billieblaze/FDL-1-Blaster/FDL-1p Wiring Diagram.jpg

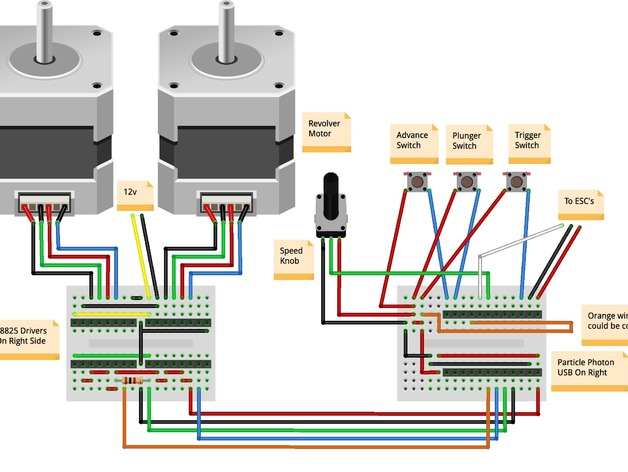
FDL-1p Wiring Diagram.jpg
