billieblaze/FDL-1-Blaster/PCB/FDL-1 Blaster Control PCB Schematic.png

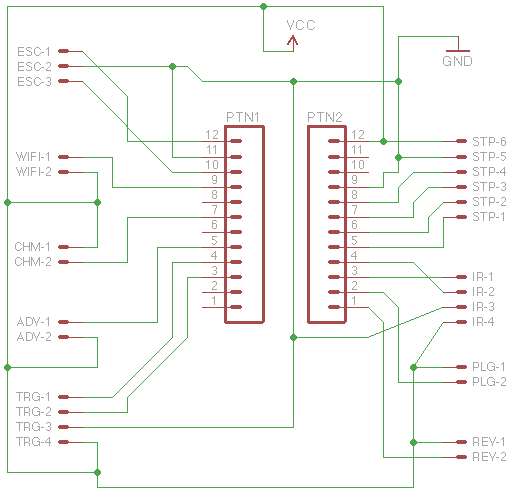
PCB/FDL-1 Blaster Control PCB Schematic.png
