billieblaze/FDL-1-Blaster/PCB/FDL-1 Blaster Stepper PCB Schematic.png

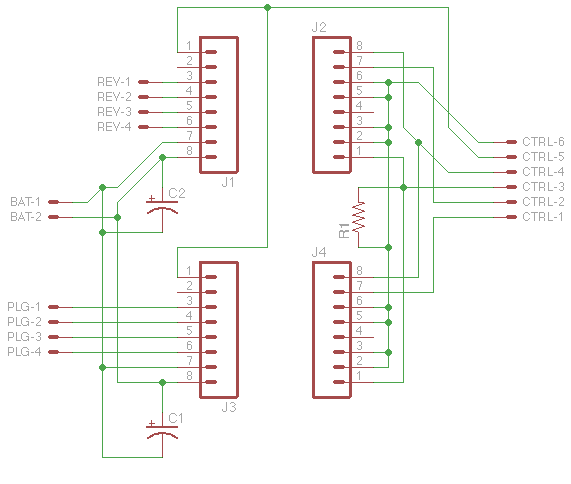
PCB/FDL-1 Blaster Stepper PCB Schematic.png
