billieblaze/FDL-1-Blaster/STL/FDL-1_Blaster_Revolver_Body_Main.stl

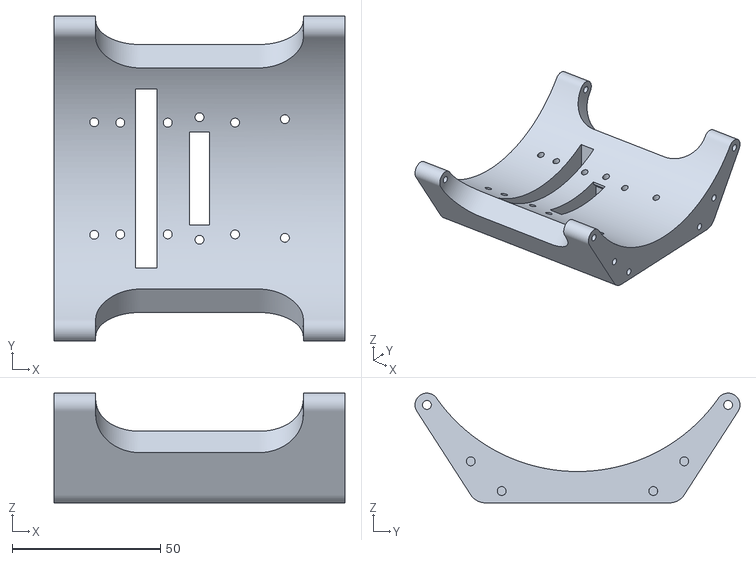
[picture p4: CAD file, 2016-08-03]
STL/FDL-1_Blaster_Revolver_Body_Main.stl
98.0 x 109.6 x 37.0
