billieblaze/FDL-1-Blaster/STL/FDL-1_Blaster_PCB_Mount_CTRL.stl

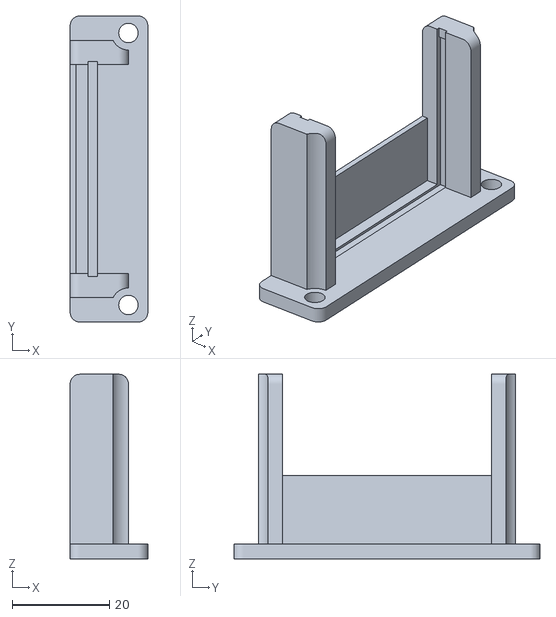
[picture p6: CAD file, 2016-08-03]
STL/FDL-1_Blaster_PCB_Mount_CTRL.stl
16.0 x 63.0 x 38.0
