billieblaze/FDL-1-Blaster/STL/FDL-1_Blaster_Barrel.stl

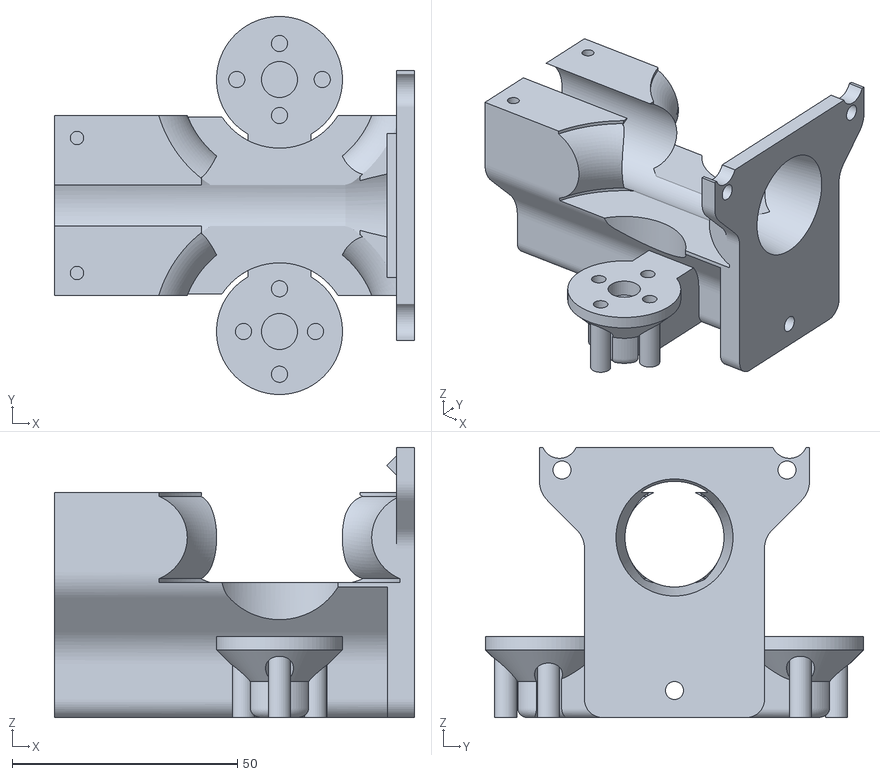
[picture p7: CAD file, 2016-08-03]
STL/FDL-1_Blaster_Barrel.stl
80.0 x 84.0 x 60.0
