billieblaze/FDL-1-Blaster/STL/FDL-1_Blaster_Rear_Spinner_Bushing.stl

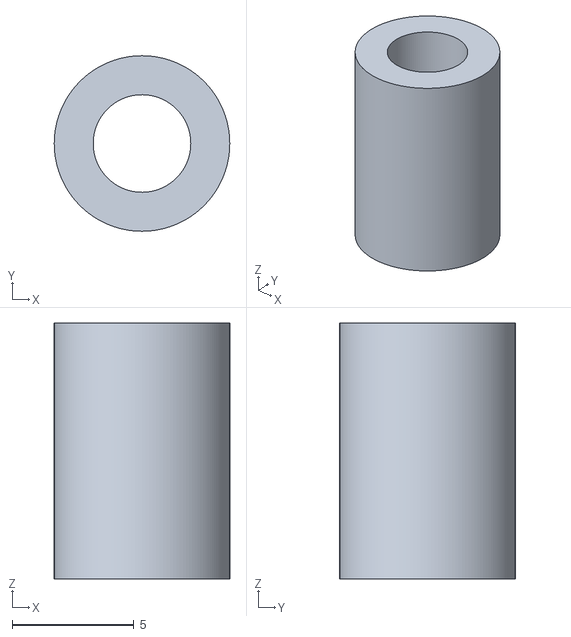
[picture p8: CAD file, 2016-08-03]
STL/FDL-1_Blaster_Rear_Spinner_Bushing.stl
7.20 x 7.20 x 10.5
