billieblaze/FDL-1-Blaster/STL/FDL-1_Blaster_Barrel_Guard_Cap.stl

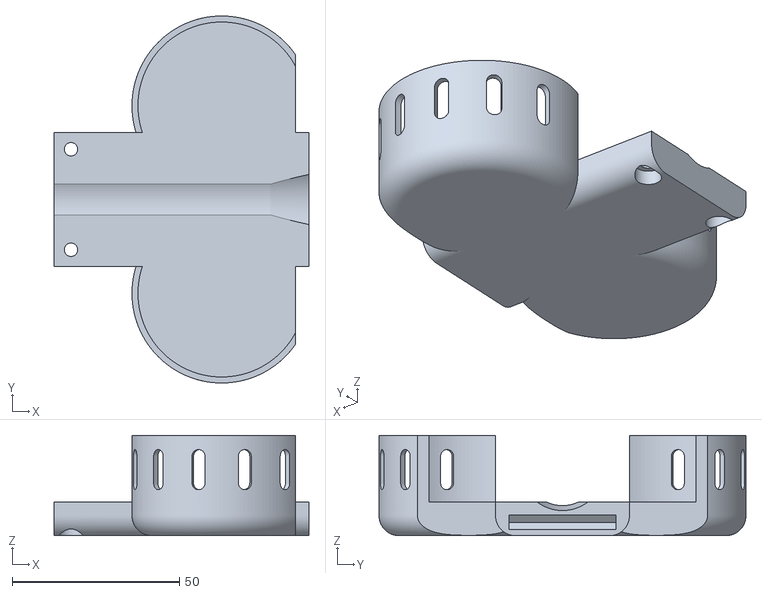
[picture p9: CAD file, 2016-08-03]
STL/FDL-1_Blaster_Barrel_Guard_Cap.stl
76.0 x 109.6 x 30.0
