billieblaze/FDL-1-Blaster/STL/FDL-1_Blaster_Rear_Angle_Right.stl

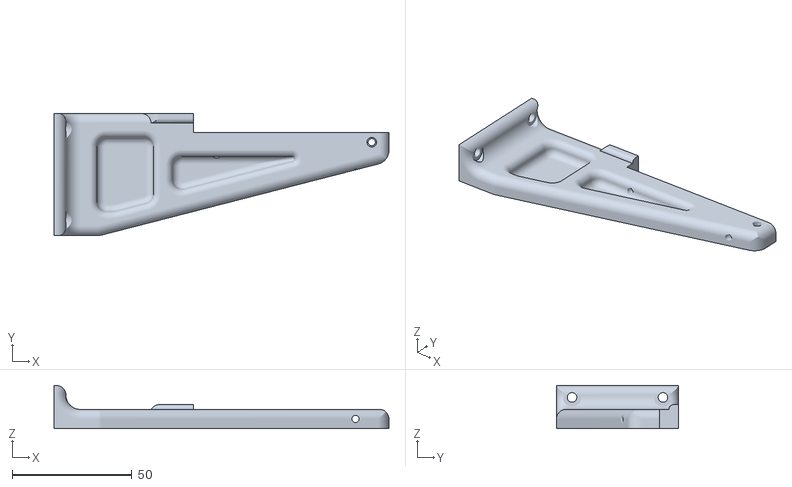
[picture p10: CAD file, 2016-08-03]
STL/FDL-1_Blaster_Rear_Angle_Right.stl
140.0 x 51.0 x 18.0
