billieblaze/FDL-1-Blaster/STL/FDL-1_Blaster_Revolver.stl

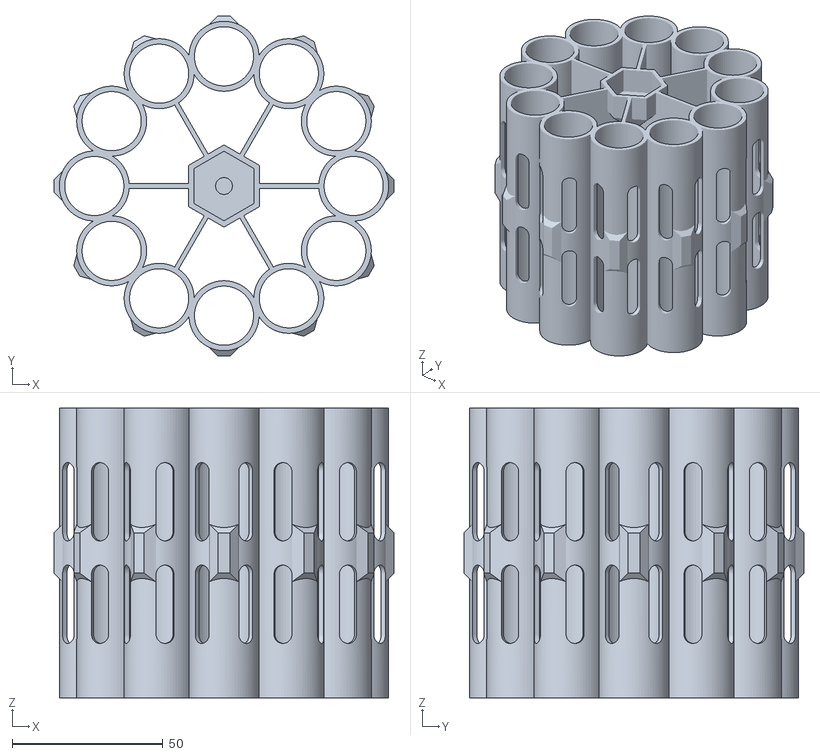
[picture p11: CAD file, 2016-08-03]
STL/FDL-1_Blaster_Revolver.stl
112.7 x 112.7 x 96.0
