billieblaze/FDL-1-Blaster/STL/FDL-1_Handle_Blaster_Plate.stl

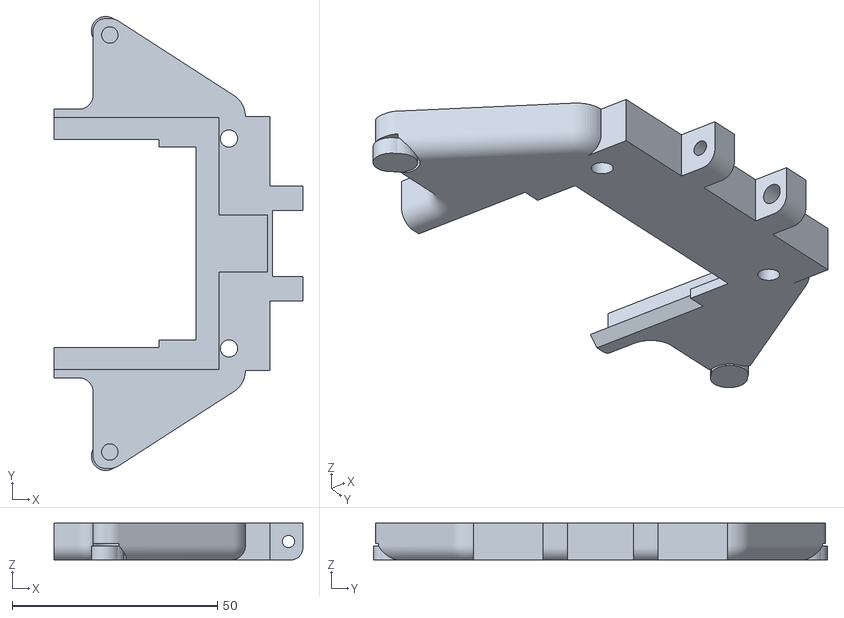
[picture p13: CAD file, 2016-08-03]
STL/FDL-1_Handle_Blaster_Plate.stl
60.6 x 110.6 x 9.00
