billieblaze/FDL-1-Blaster/STL/FDL-1_Blaster_PCB_Mount_STP.stl

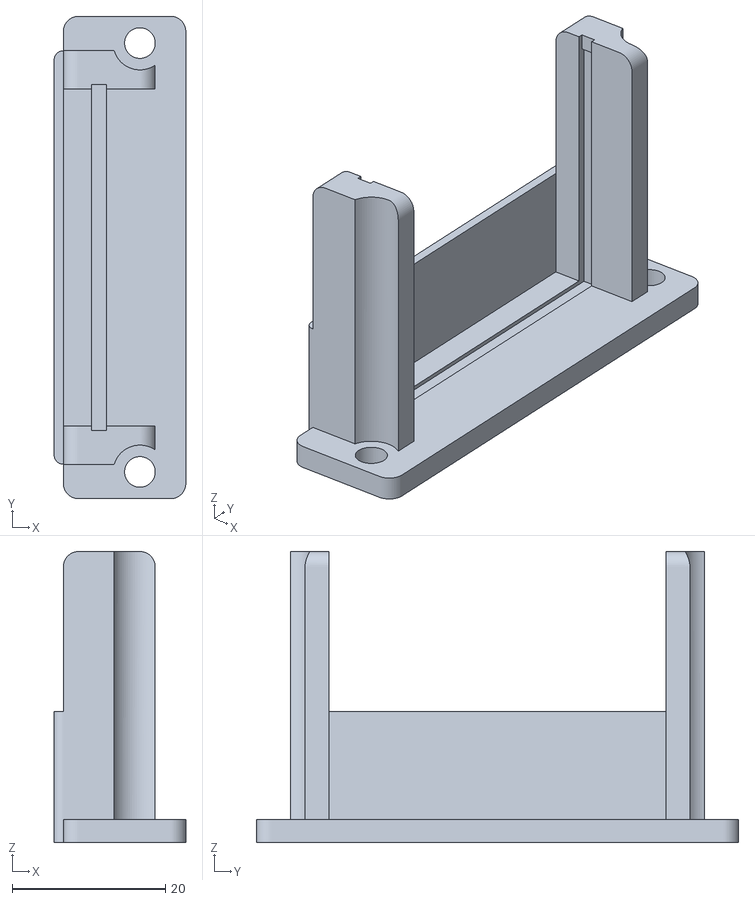
[picture p14: CAD file, 2016-08-03]
STL/FDL-1_Blaster_PCB_Mount_STP.stl
17.2 x 63.0 x 38.0
