billieblaze/FDL-1-Blaster/STL/FDL-1_Blaster_ESC_Power_Distro.stl

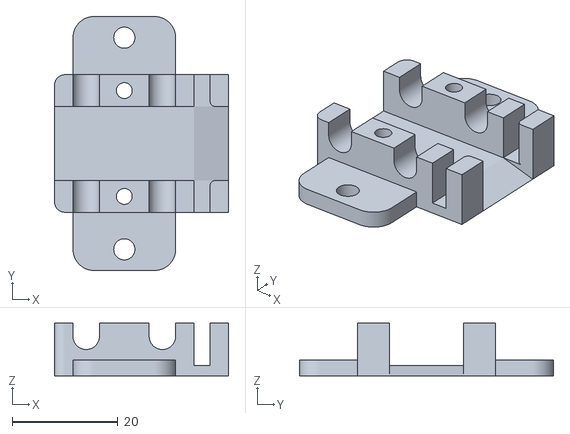
[picture p15: CAD file, 2016-08-03]
STL/FDL-1_Blaster_ESC_Power_Distro.stl
32.9 x 48.0 x 10.0
