billieblaze/FDL-1-Blaster/STL/FDL-1_Blaster_Flywheel_x2.stl

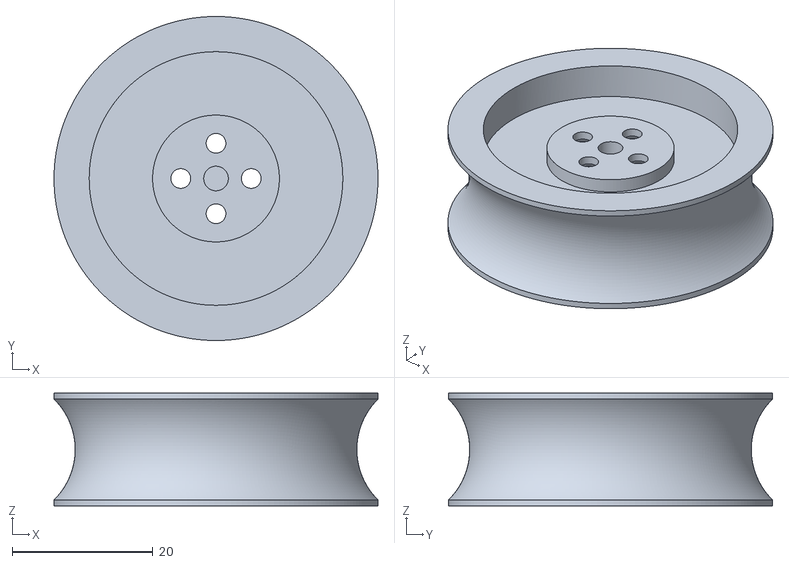
[picture p16: CAD file, 2016-08-03]
STL/FDL-1_Blaster_Flywheel_x2.stl
46.0 x 46.0 x 16.0
