billieblaze/FDL-1-Blaster/STL/FDL-1_Blaster_Revolver_Body_Brace_x2.stl

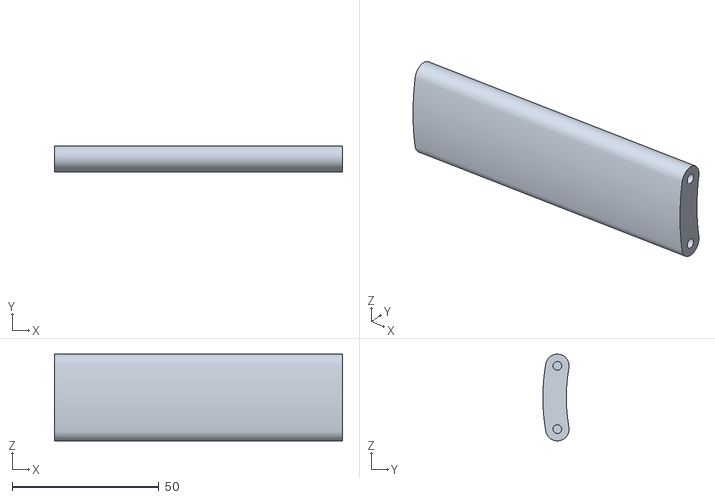
[picture p17: CAD file, 2016-08-03]
STL/FDL-1_Blaster_Revolver_Body_Brace_x2.stl
98.0 x 8.94 x 29.5
