billieblaze/FDL-1-Blaster/STL/FDL-1_Handle_Plate_Right.stl

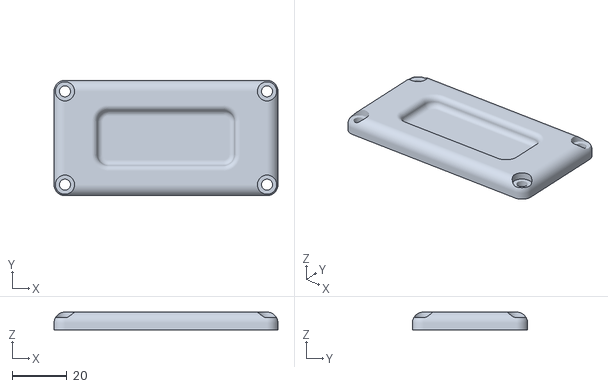
[picture p18: CAD file, 2016-08-03]
STL/FDL-1_Handle_Plate_Right.stl
81.6 x 42.0 x 6.50
