billieblaze/FDL-1-Blaster/STL/FDL-1_Blaster_ESC_Bracket_Left.stl

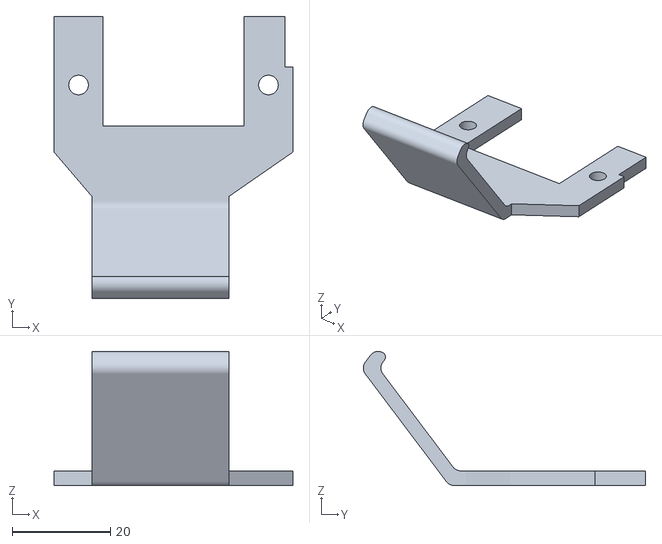
[picture p19: CAD file, 2016-08-03]
STL/FDL-1_Blaster_ESC_Bracket_Left.stl
48.7 x 57.6 x 27.3
