billieblaze/FDL-1-Blaster/STL/FDL-1_Blaster_Rear_Plate_Switch_Cap.stl

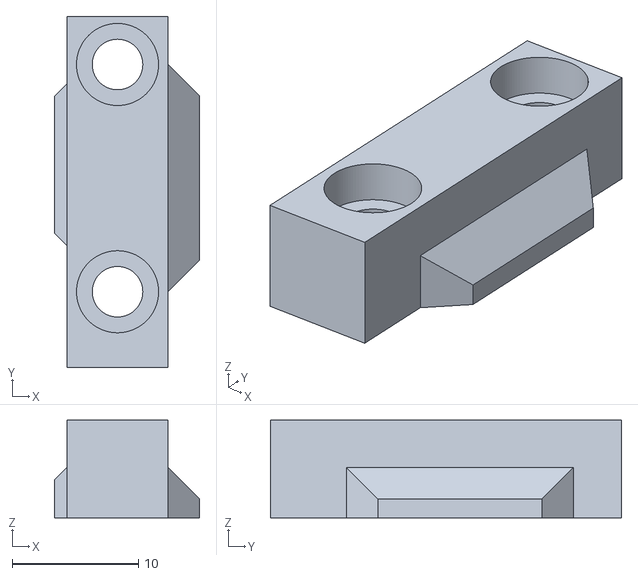
[picture p20: CAD file, 2016-08-03]
STL/FDL-1_Blaster_Rear_Plate_Switch_Cap.stl
11.5 x 27.8 x 7.75
