billieblaze/FDL-1-Blaster/STL/FDL-1_Blaster_Rear_Plunger_Guide_wSwitches.stl

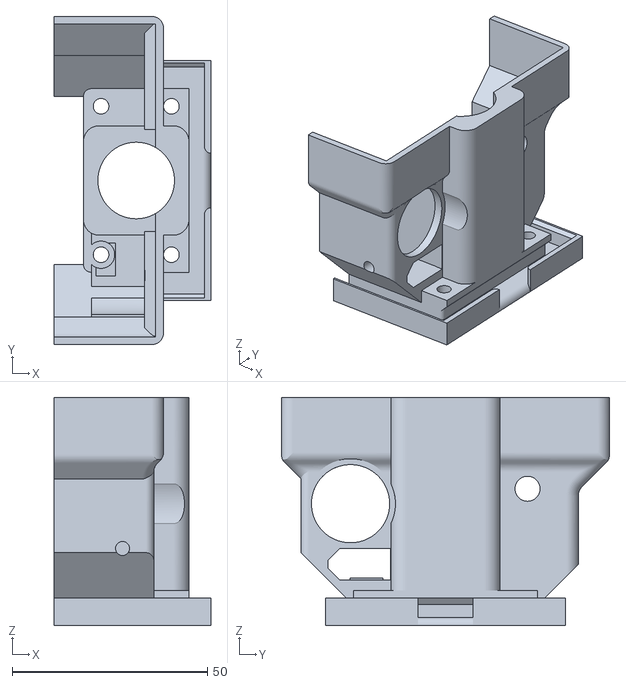
[picture p21: CAD file, 2016-08-03]
STL/FDL-1_Blaster_Rear_Plunger_Guide_wSwitches.stl
40.1 x 84.0 x 58.4
