billieblaze/FDL-1-Blaster/STL/FDL-1_Blaster_Rear_Angle_Left_Cap.stl

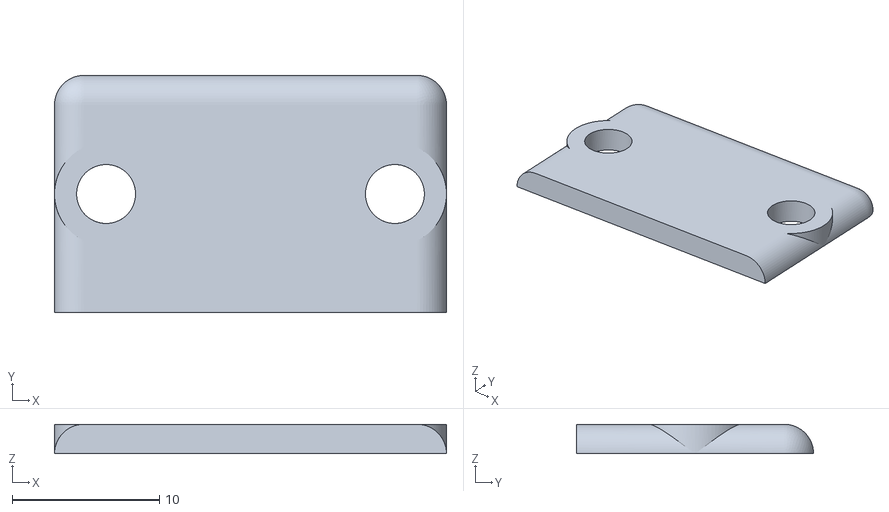
[picture p22: CAD file, 2016-08-03]
STL/FDL-1_Blaster_Rear_Angle_Left_Cap.stl
26.6 x 16.1 x 2.00
