billieblaze/FDL-1-Blaster/STL/FDL-1_Blaster_Rear_Plate.stl

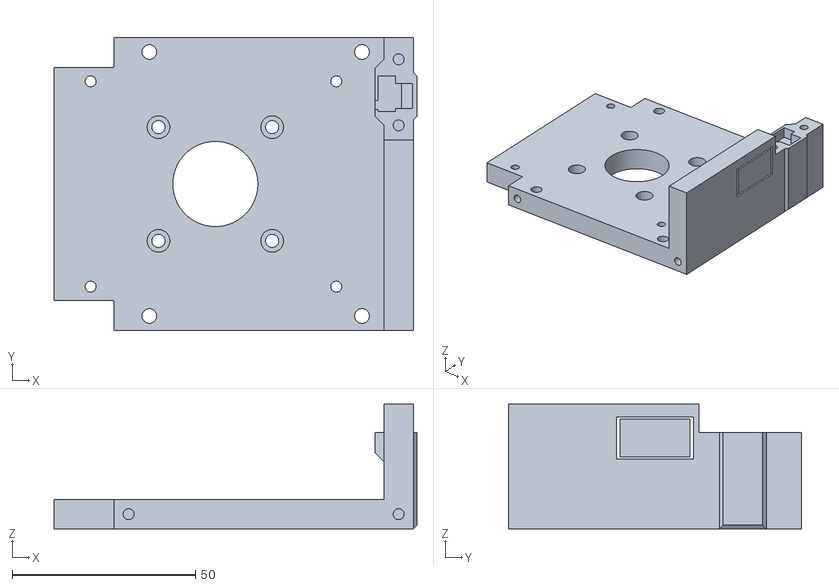
[picture p23: CAD file, 2016-08-03]
STL/FDL-1_Blaster_Rear_Plate.stl
99.0 x 80.0 x 34.0
