billieblaze/FDL-1-Blaster/STL/FDL-1_Blaster_Rear_Electronics_Box.stl

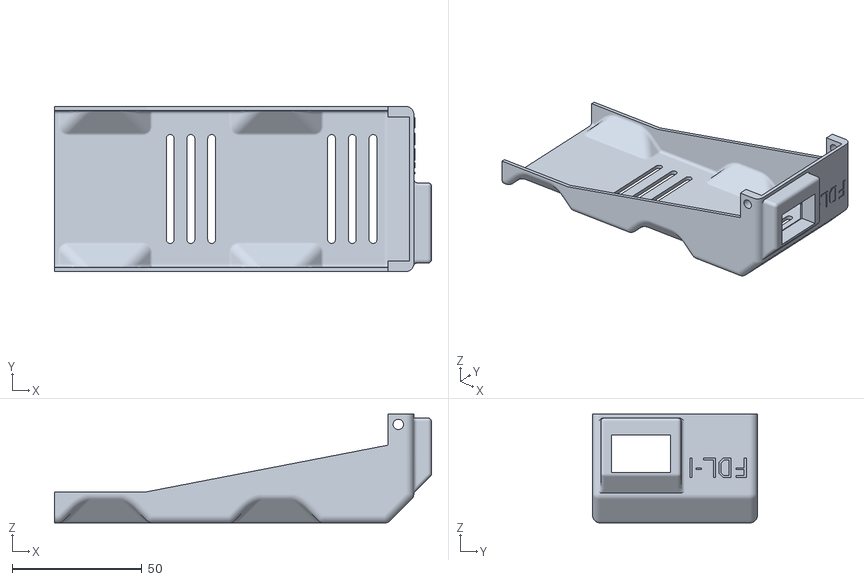
[picture p25: CAD file, 2016-08-03]
STL/FDL-1_Blaster_Rear_Electronics_Box.stl
145.4 x 63.6 x 42.0
