billieblaze/FDL-1-Blaster/STL/FDL-1_Blaster_Rear_Spinner.stl

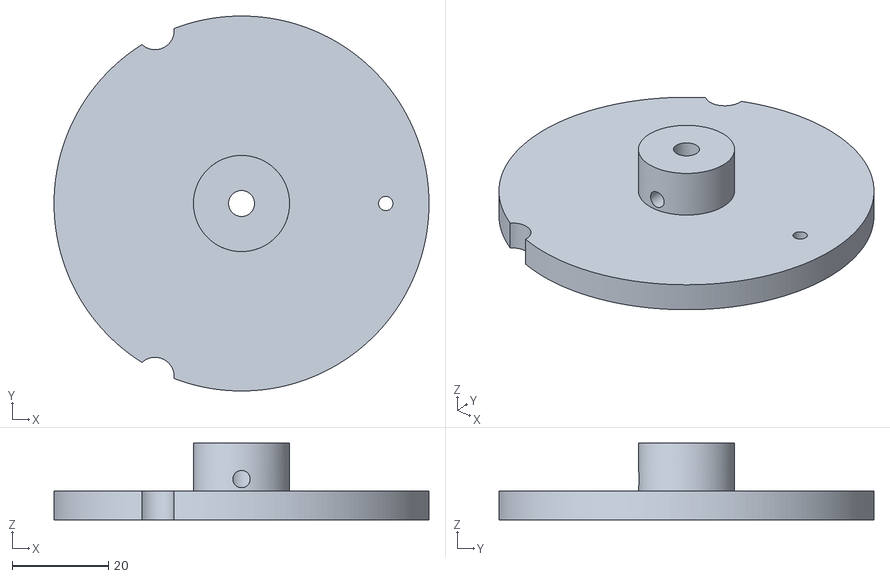
[picture p26: CAD file, 2016-08-03]
STL/FDL-1_Blaster_Rear_Spinner.stl
78.0 x 78.0 x 16.0
