billieblaze/FDL-1-Blaster/STL/FDL-1_Handle_Plate_Left_Cap.stl

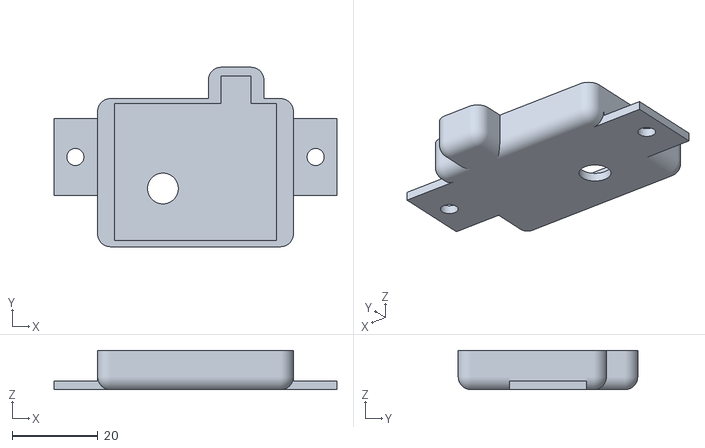
[picture p27: CAD file, 2016-08-03]
STL/FDL-1_Handle_Plate_Left_Cap.stl
66.2 x 42.0 x 9.20
