billieblaze/FDL-1-Blaster/STL/FDL-1_Blaster_Revolver_Body_ElecCap.stl

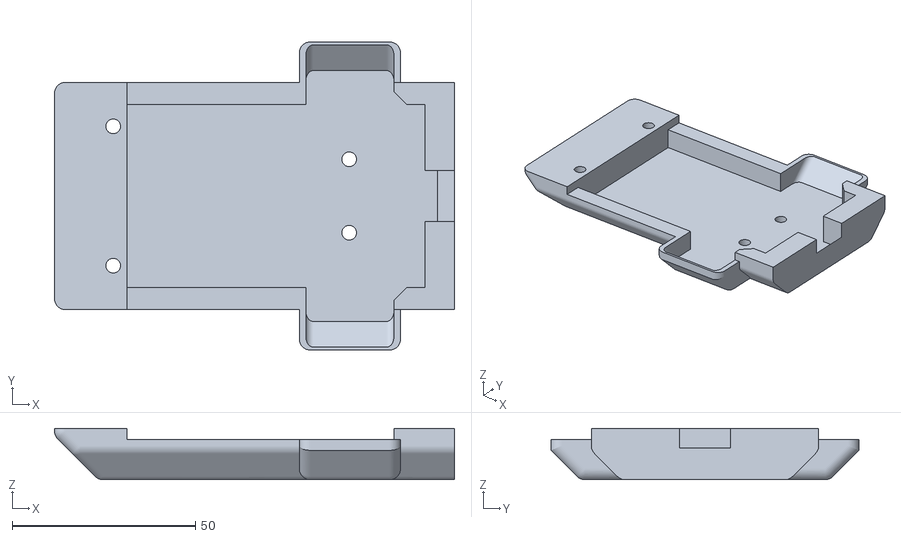
[picture p28: CAD file, 2016-08-03]
STL/FDL-1_Blaster_Revolver_Body_ElecCap.stl
109.0 x 84.0 x 14.0
