billieblaze/FDL-1-Blaster/STL/FDL-1_Handle_Guard.stl

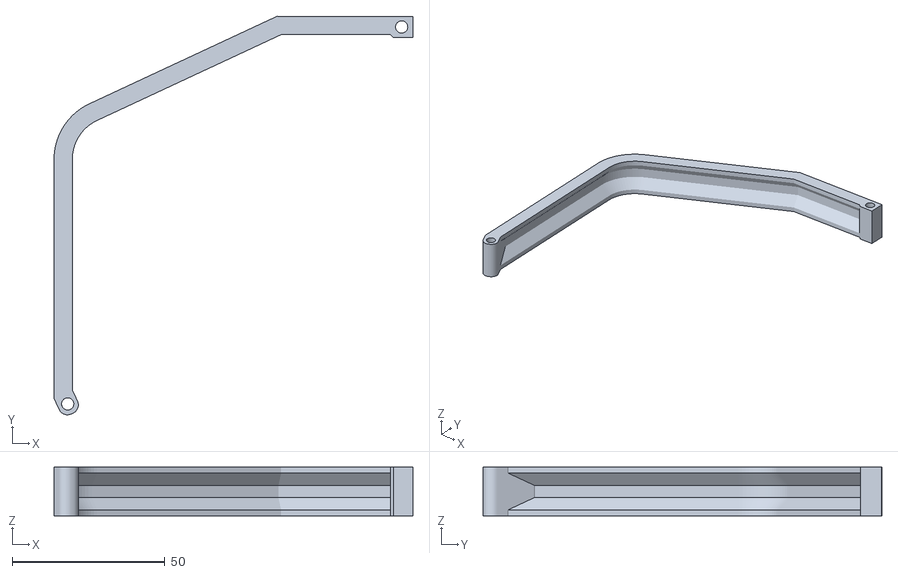
[picture p29: CAD file, 2016-08-03]
STL/FDL-1_Handle_Guard.stl
117.3 x 130.3 x 16.0
