billieblaze/FDL-1-Blaster/STL/FDL-1_Handle.stl

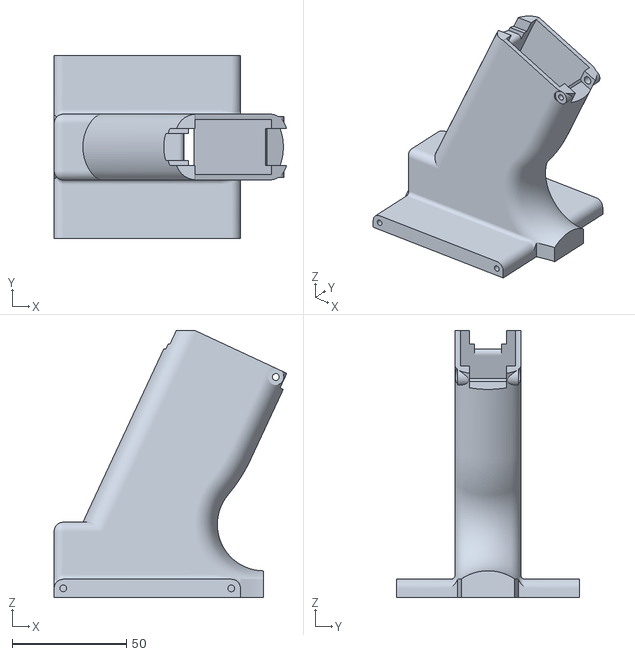
[picture p30: CAD file, 2016-08-03]
STL/FDL-1_Handle.stl
102.0 x 80.0 x 117.0
