billieblaze/FDL-1-Blaster/STL/FDL-1_Blaster_Revolver_Motor_Adapter.stl

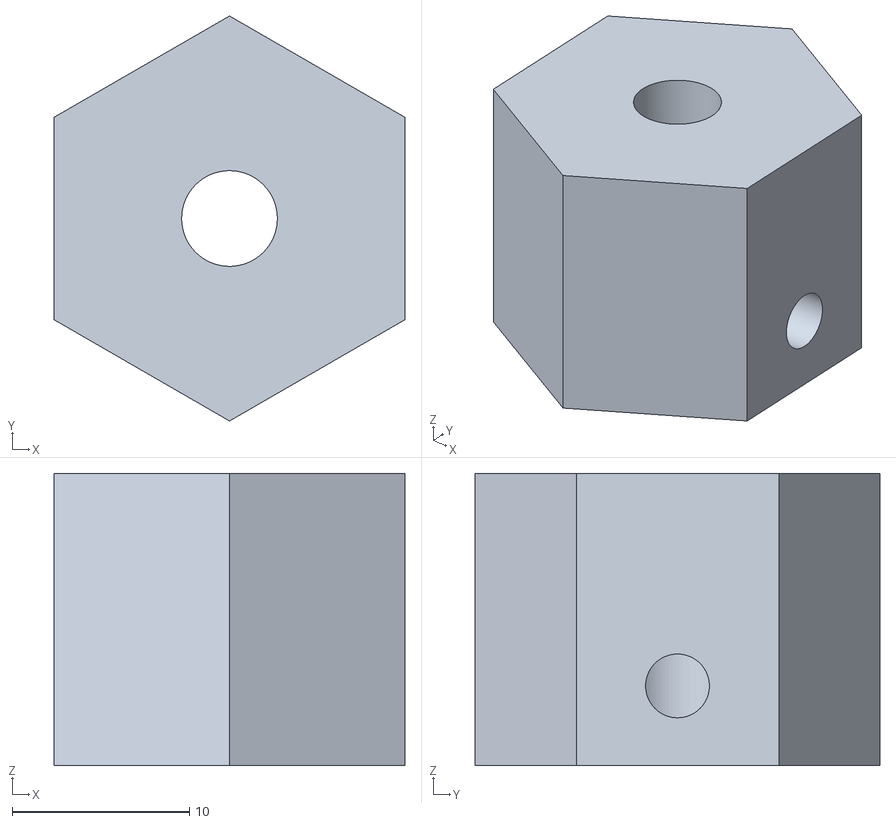
[picture p31: CAD file, 2016-08-03]
STL/FDL-1_Blaster_Revolver_Motor_Adapter.stl
19.8 x 22.9 x 16.5
