billieblaze/FDL-1-Blaster/STL/FDL-1_Blaster_ESC_Wire_Guide_x2.stl

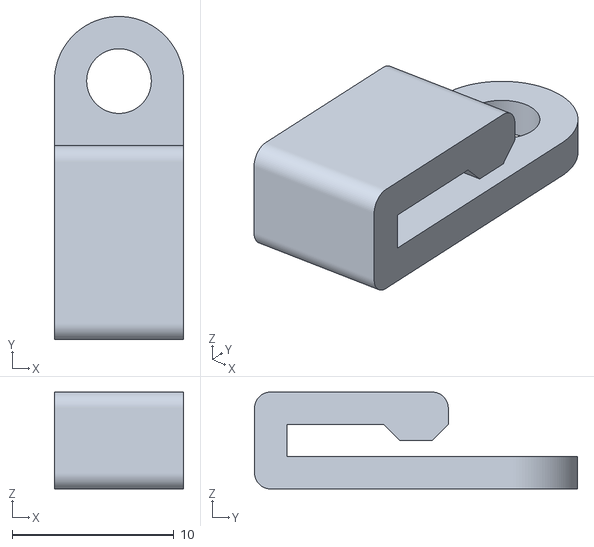
[picture p32: CAD file, 2016-08-03]
STL/FDL-1_Blaster_ESC_Wire_Guide_x2.stl
8.00 x 20.0 x 6.00
