billieblaze/FDL-1-Blaster/STL/FDL-1_Blaster_Revolver_Switch.stl

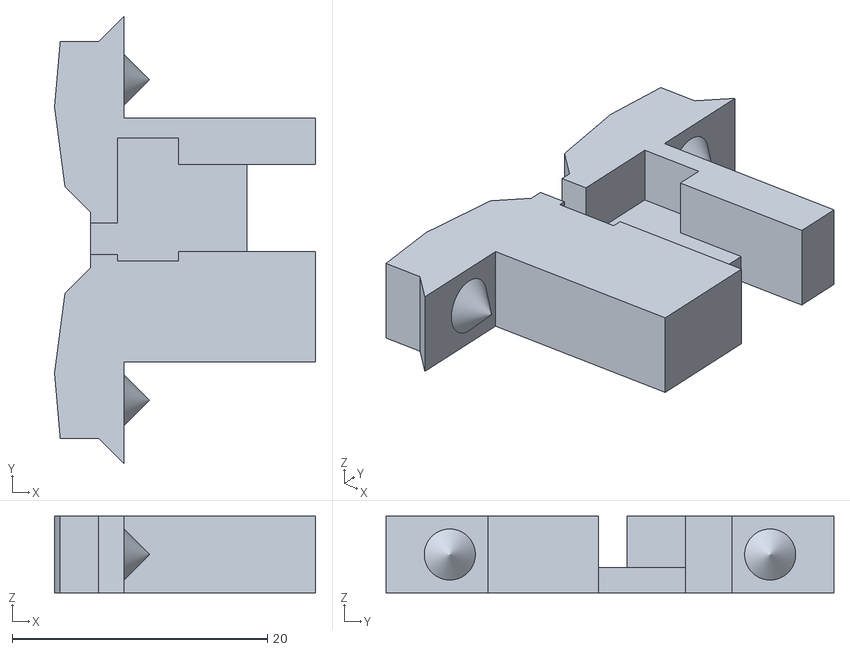
[picture p33: CAD file, 2016-08-03]
STL/FDL-1_Blaster_Revolver_Switch.stl
20.4 x 35.1 x 6.00
