billieblaze/FDL-1-Blaster/STL/FDL-1_Blaster_Revolver_Switch_Retainer.stl

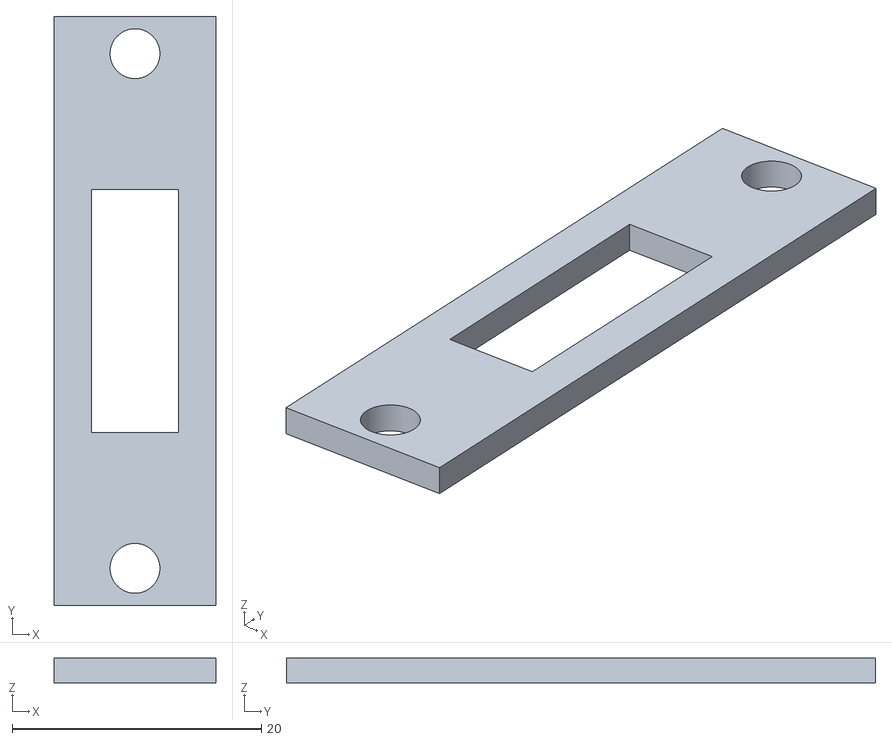
[picture p34: CAD file, 2016-08-03]
STL/FDL-1_Blaster_Revolver_Switch_Retainer.stl
13.0 x 47.3 x 2.00
