billieblaze/FDL-1-Blaster/STL/FDL-1_Blaster_Revolver_Bushing.stl

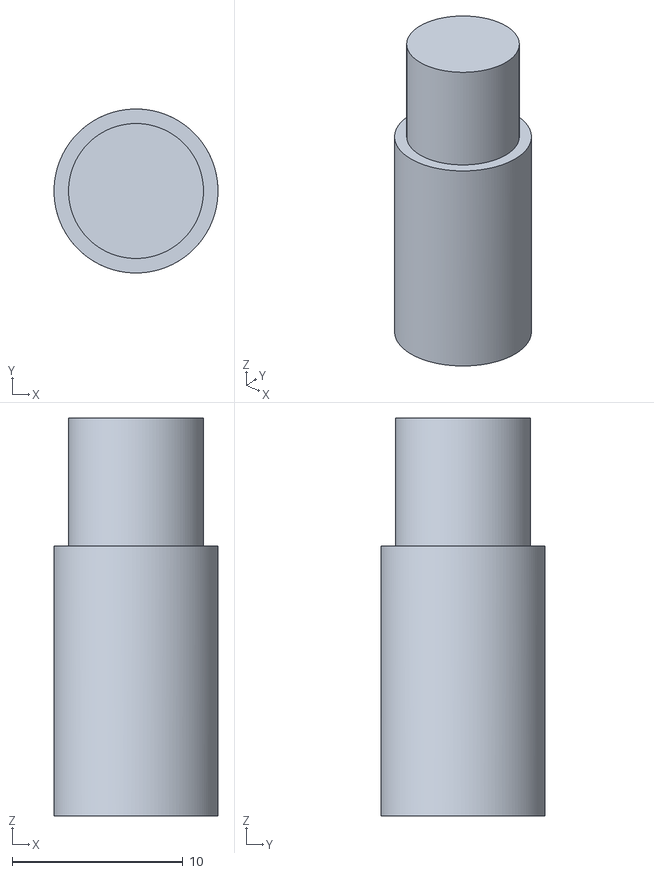
[picture p35: CAD file, 2016-08-03]
STL/FDL-1_Blaster_Revolver_Bushing.stl
9.60 x 9.60 x 23.3
