billieblaze/FDL-1-Blaster/STL/FDL-1_Blaster_Revolver_IR_Mount.stl

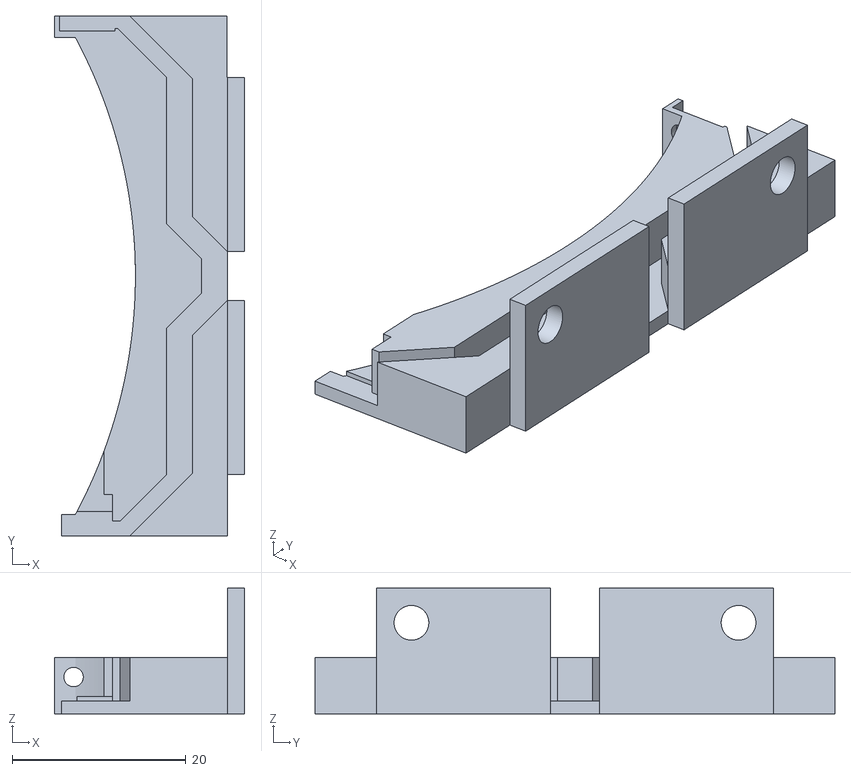
[picture p36: CAD file, 2016-08-03]
STL/FDL-1_Blaster_Revolver_IR_Mount.stl
21.9 x 59.9 x 14.5
