billieblaze/FDL-1-Blaster/STL/FDL-1_Blaster_Rear_Plunger.stl

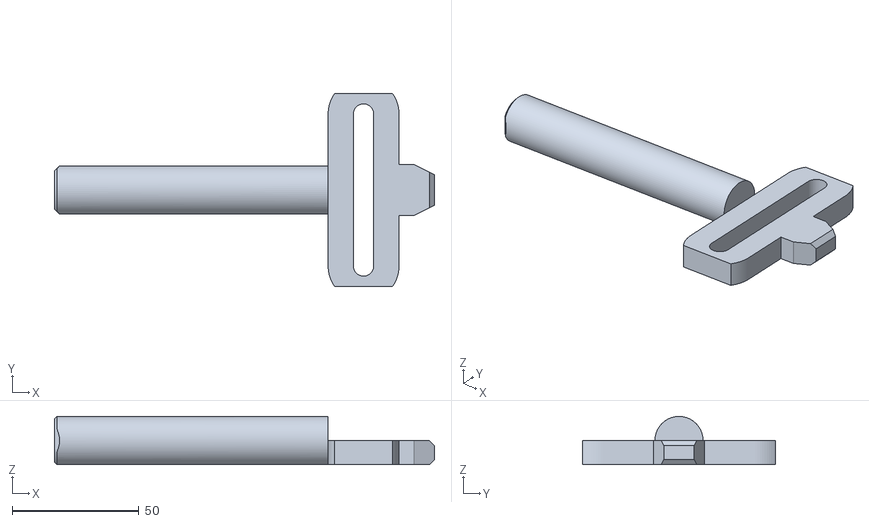
[picture p37: CAD file, 2016-08-03]
STL/FDL-1_Blaster_Rear_Plunger.stl
150.0 x 76.0 x 19.0
