billieblaze/FDL-1-Blaster/STL/FDL-1_Blaster_Revolver_Body_Plate_Back.stl

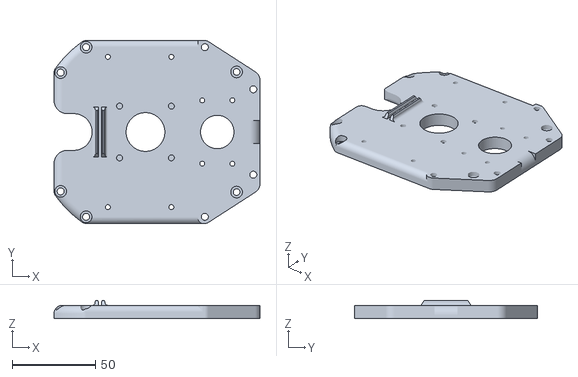
[picture p38: CAD file, 2016-08-03]
STL/FDL-1_Blaster_Revolver_Body_Plate_Back.stl
123.4 x 109.6 x 11.0
