billieblaze/FDL-1-Blaster/(list of files, cad)

Other CAD files:
STL/FDL-1_Blaster_ESC_Bracket_Right.stl
