billieblaze/FDL-1-Blaster/PCB/FDL-1 BSTP v1.0.sch

## EAGLE design PCB/FDL-1 BSTP v1.0.sch (2016-08-09)

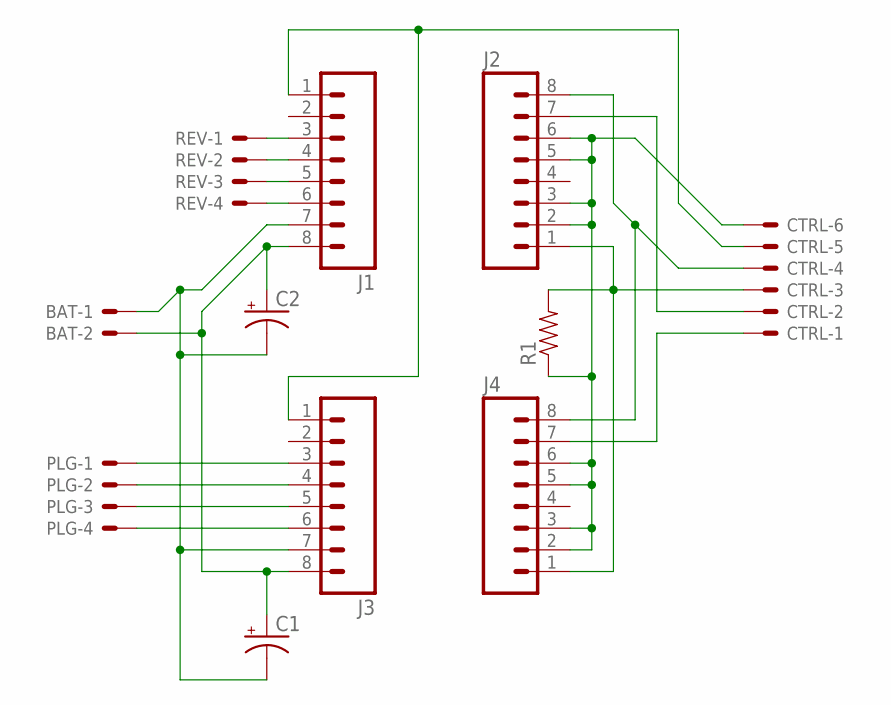
[picture p39: schematic FDL-1 BSTP v1.0.sch]

Parts:
BAT: JST-XH-02-PIN-LONG-PAD; JST-XH-02-PACKAGE-LONG-PAD
C1, C2: CAP_POLPTH1; CPOL-RADIAL-100UF-25V
CTRL: JST-XH-06-PIN-LONG-PAD; JST-XH-06-PACKAGE-LONG-PAD
J1, J2, J3, J4: M08SILK_FEMALE_PTH; 1X08
PLG: JST-XH-04-PIN-LONG-PAD; JST-XH-04-PACKAGE-LONG-PAD
R1: RESISTORPTH-1/4W; AXIAL-0.4
REV: JST-XH-04-PIN-LONG-PAD; JST-XH-04-PACKAGE-LONG-PAD

Connections:
unnamed: J1.6, REV.4
unnamed: J1.5, REV.3
unnamed: J1.4, REV.2
unnamed: J1.3, REV.1
unnamed: J3.6, PLG.4
unnamed: J3.5, PLG.3
unnamed: J3.4, PLG.2
unnamed: J3.3, PLG.1
unnamed: BAT.2, C1.1 (+), C2.1 (+), J1.8, J3.8
unnamed: CTRL.6, J2.2, J2.3, J2.5, J2.6, J4.2, J4.3, J4.5, J4.6, R1.P$1 (1)
unnamed: CTRL.3, J2.1, J4.1, R1.P$2 (2)
unnamed: CTRL.4, J2.8, J4.8
unnamed: CTRL.5, J1.1, J3.1
unnamed: CTRL.2, J2.7
unnamed: CTRL.1, J4.7
unnamed: BAT.1, C1.2 (-), C2.2 (-), J1.7, J3.7
