billieblaze/FDL-1-Blaster/PCB/FDL-1 CTRL v1.0.sch

## EAGLE design PCB/FDL-1 CTRL v1.0.sch (2016-08-09)

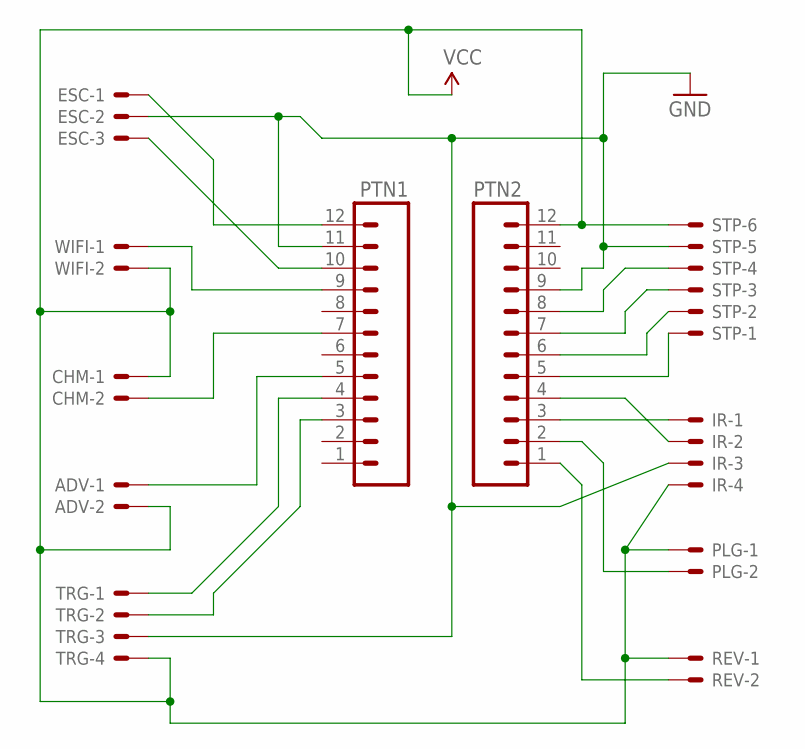
[picture p40: schematic FDL-1 CTRL v1.0.sch]

Parts:
ADV: JST-XH-02-PIN-LONG-PAD; JST-XH-02-PACKAGE-LONG-PAD
CHM: JST-XH-02-PIN-LONG-PAD; JST-XH-02-PACKAGE-LONG-PAD
ESC: JST-XH-03-PIN-LONG-PAD; JST-XH-03-PACKAGE-LONG-PAD
IR: JST-XH-04-PIN-LONG-PAD; JST-XH-04-PACKAGE-LONG-PAD
PLG: JST-XH-02-PIN-LONG-PAD; JST-XH-02-PACKAGE-LONG-PAD
PTN1, PTN2: M12PTH; 1X12
REV: JST-XH-02-PIN-LONG-PAD; JST-XH-02-PACKAGE-LONG-PAD
STP: JST-XH-06-PIN-LONG-PAD; JST-XH-06-PACKAGE-LONG-PAD
TRG: JST-XH-04-PIN-LONG-PAD; JST-XH-04-PACKAGE-LONG-PAD
WIFI: JST-XH-02-PIN-LONG-PAD; JST-XH-02-PACKAGE-LONG-PAD

Connections:
GND: ESC.2, IR.3, PTN1.11, PTN2.9, STP.5, TRG.3
unnamed: IR.2, PTN2.4
unnamed: ESC.1, PTN1.12
unnamed: PTN1.3, TRG.2
unnamed: ESC.3, PTN1.10
unnamed: PTN1.9, WIFI.1
unnamed: IR.1, PTN2.3
unnamed: ADV.1, PTN1.5
unnamed: CHM.2, PTN1.7
unnamed: PLG.2, PTN2.2
unnamed: PTN2.1, REV.2
unnamed: PTN2.8, STP.4
unnamed: PTN2.7, STP.3
unnamed: PTN2.6, STP.2
unnamed: PTN2.5, STP.1
unnamed: PTN1.4, TRG.1
VCC: ADV.2, CHM.1, IR.4, PLG.1, PTN2.12, REV.1, STP.6, TRG.4, WIFI.2
