billieblaze/FDL-1-Blaster/(commit log)

2016-08-03 Adding stl files
    [FDL-1_Blaster_Barrel.stl, FDL-1_Blaster_Barrel_Guard_Cap.stl, FDL-1_Blaster_ESC_Bracket_Left.stl, FDL-1_Blaster_ESC_Bracket_Right.stl, FDL-1_Blaster_ESC_Power_Distro.stl, FDL-1_Blaster_ESC_Wire_Guide_x2.stl, FDL-1_Blaster_Flywheel_x2.stl, FDL-1_Blaster_PCB_Mount_CTRL.stl]
2016-08-09 Adding board schematics
    [FDL-1 BSTP v1.0.sch, FDL-1 CTRL v1.0.sch]
2016-08-09 Adding pcb schematic png's
2016-08-09 Adding prototype wiring diagram
2016-08-10 Adding blaster BOM
